servodevelop/touch-leader-arm/hardware/README.md

# Touch R1 Leader Arm 硬件

[← 首页](../README.md)　|　<sub>**简体中文**</sub>

所提供 V3.1 模型的 CAD 资源及按装配体提取的物料清单。

**目录：**

- [⚙️ 产品规格](#specifications)
- [📂 资源目录](#resources)
- [📐 装配模型](#assembly-model)
- [📋 物料清单](#bill-of-materials)
- [🔎 待确认事项](#confirmation)
- [🛠️ 装配与校准](#assembly-and-calibration)
- [✅ 验证状态](#validation-status)

## 产品规格

| 规格 | Touch R1 Leader Arm |
| --- | --- |
| 硬件版本 | V3.1，依据所提供装配体的文件名标注 |
| 产品类型 | 遥操作主臂 |
| 自由度 | 待确认 |
| 臂展与重量 | 待确认 |
| 电源与通信 | 待确认 |
| 执行器与编码器 | 待确认 |
| 关节运动范围 | 待确认 |

## 资源目录

| 目录／文件 | 内容 | 状态 |
| --- | --- | --- |
| [step/assembly/](step/assembly/) | 原始 V3.1 装配体 STEP | 源文件字节保持不变；已检查 CAD 导入 |
| [step/parts/](step/parts/) | 16 份独立零件或子装配 STEP | 已通过导出与重新导入检查 |
| [bom.json](bom.json) | BOM 数量、源编号、实例位置及几何检查结果 | 根据源装配树提取 |
| [printing/stl/](printing/stl/) | 可打印的零件网格 | 待补充 |
| [printing/3mf/](printing/3mf/) | 独立零件与整套打印项目 | 待补充 |
| [drawings/](drawings/) | 带尺寸工程图纸，PDF／DWG | 待补充 |
| [robot-description/](robot-description/) | URDF、网格和可视化说明 | 仅有框架；模型待补充 |

## 装配模型

[下载 V3.1 装配体 STEP](step/assembly/touch-leader-arm-v3.1-1013.stp)。

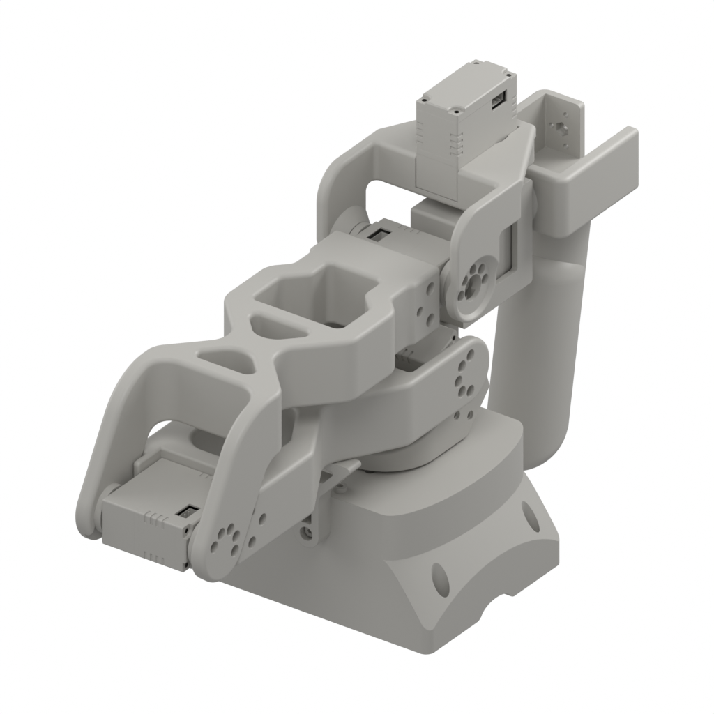
[picture p1: hardware/touch-leader-arm/images/touch-r1-assembly.png]
Touch R1 V3.1 CAD 装配体


所提供的文件 `遥操臂V3.1_1013.stp` 以 `touch-leader-arm-v3.1-1013.stp` 保存，内容未作修改。STEP 文件头记录的导出软件为 Creo Parametric，导出时间为 `2026-10-13T11:21:50`。版本标注来自源文件名。

独立 STEP 保留各组件自身的 CAD 坐标系；舵机导出件保留内部几何，作为完整子装配提供。这些文件为参考 CAD 导出件，尚未指定制造或打印工艺。

## 物料清单

下表列出一套所提供装配体中的 **16 种源项目、21 个顶层实例**。数量来自 STEP 装配引用，按源 PRODUCT 标识合并重复件。两类舵机子装配各出现 3 次，其内部零件已包含在子装配中，不再重复列为采购项。展开全部子装配后为 **99 个叶级实例／实体**，不代表需要采购 99 件物料。

结构件的资源标识与 STEP、图片文件名主体一致（不含扩展名）；螺钉采用 102 的“品名＋直径 × 长度”规格写法，链接仍指向对应 STEP。包括紧固件在内的全部简图均由源 STEP 几何渲染为 **1024 × 1024 白底图片**，点击可放大。统一灰色显示材质不代表实物材质、颜色或表面处理；各图独立缩放。

表内 CAD 包围尺寸为**零件本地坐标轴 X × Y × Z 的包围盒尺寸**，四舍五入到 0.01 mm，仅描述模型外包范围，不是工程尺寸、公差、螺纹尺寸或采购规格。螺钉条目另按圆柱面测量杆径、头径、头高及头下长度，**M3 × 4 为 CAD 推定规格**，不表示螺纹已确认。这份 CAD 提取 BOM 需要工程确认后才能用于采购；不会推测补入源模型中缺失的组件。

| 序号 | 品名 | 型号／规格 | 图片 | 描述 | 数量 |
| :---: | --- | --- | :---: | --- | :---: |
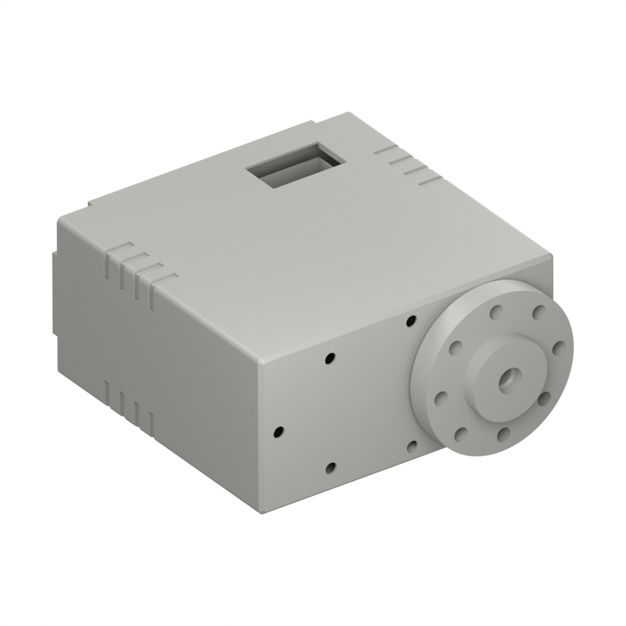
[picture p2: hardware/images/touch-r1-servo-rp8-u45h-m-c028.png]
touch-r1-servo-rp8-u45h-m-c028
| 1 | 舵机子装配 | [touch-r1-servo-rp8-u45h-m-c028](step/parts/touch-r1-servo-rp8-u45h-m-c028.step) |  | 源名称：`RP8-U45H-M-C028_STEP_ASM`<br>CAD 包围尺寸：40.10 × 45.80 × 20.21 mm。<br>源标签为 RP8-U45H-M-C028；含舵盘及内部 CAD 零件。交付配置待确认。 | 3 |
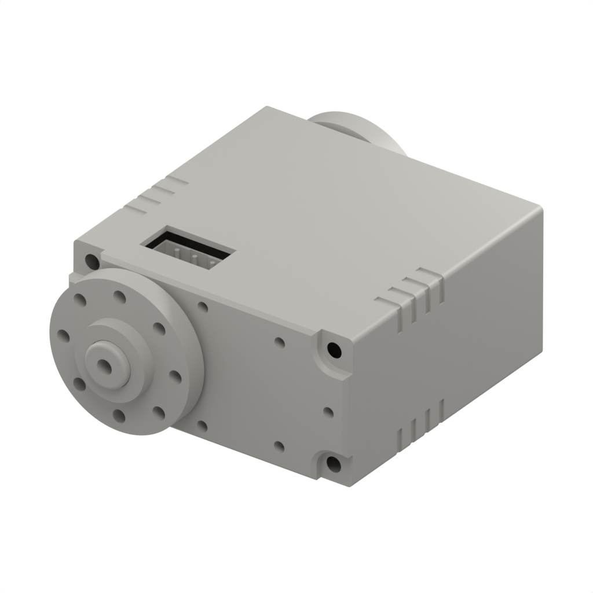
[picture p3: hardware/images/touch-r1-servo-25-50kg-0001.png]
touch-r1-servo-25-50kg-0001
| 2 | 舵机子装配（型号待确认） | [touch-r1-servo-25-50kg-0001](step/parts/touch-r1-servo-25-50kg-0001.step) |  | 源名称：`_25-50KG-0001_ASM_ASM`<br>CAD 包围尺寸：40.10 × 52.60 × 20.21 mm。<br>源标签为通用装配编号，不能据此确定采购型号；含舵盘及内部零件。 | 3 |
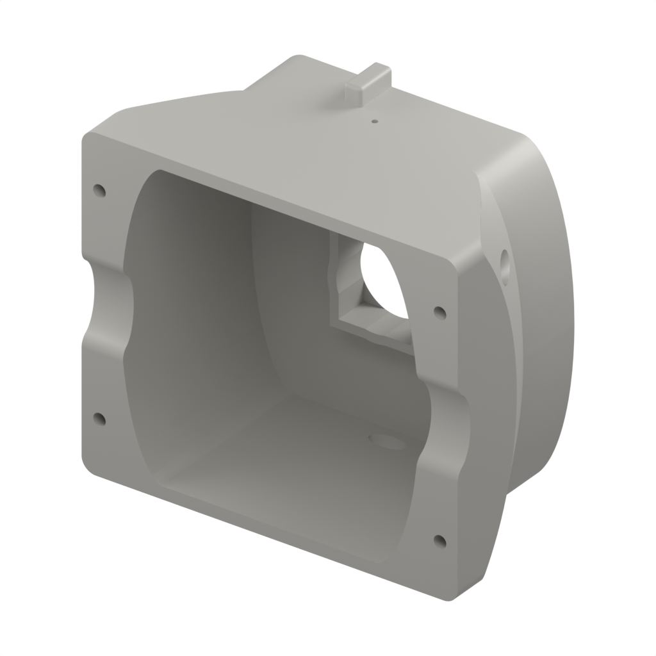
[picture p4: hardware/images/touch-r1-joint-1.png]
touch-r1-joint-1
| 3 | 关节 1 结构件 | [touch-r1-joint-1](step/parts/touch-r1-joint-1.step) |  | 源名称：`关节1_NEW`<br>CAD 包围尺寸：120.03 × 56.00 × 120.02 mm。<br>材质与制造工艺待确认。 | 1 |
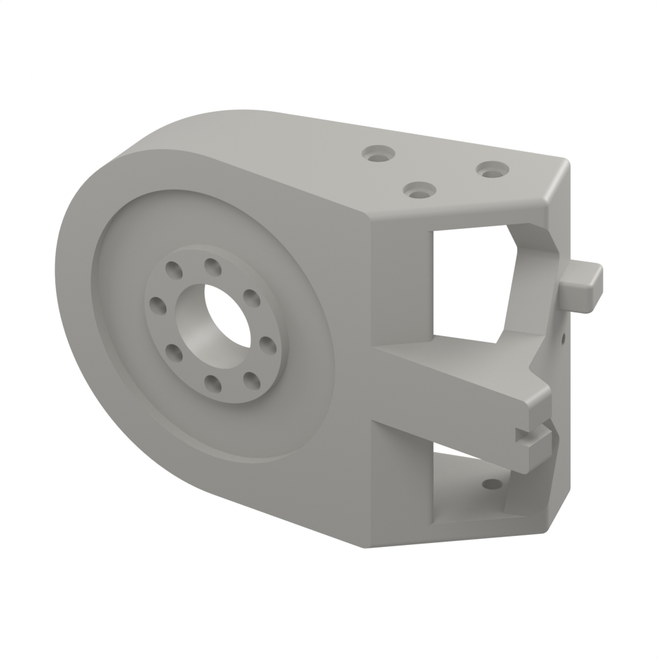
[picture p5: hardware/images/touch-r1-joint-2.png]
touch-r1-joint-2
| 4 | 关节 2 结构件 | [touch-r1-joint-2](step/parts/touch-r1-joint-2.step) |  | 源名称：`关节2_新`<br>CAD 包围尺寸：69.27 × 27.42 × 46.15 mm。<br>材质与制造工艺待确认。 | 1 |
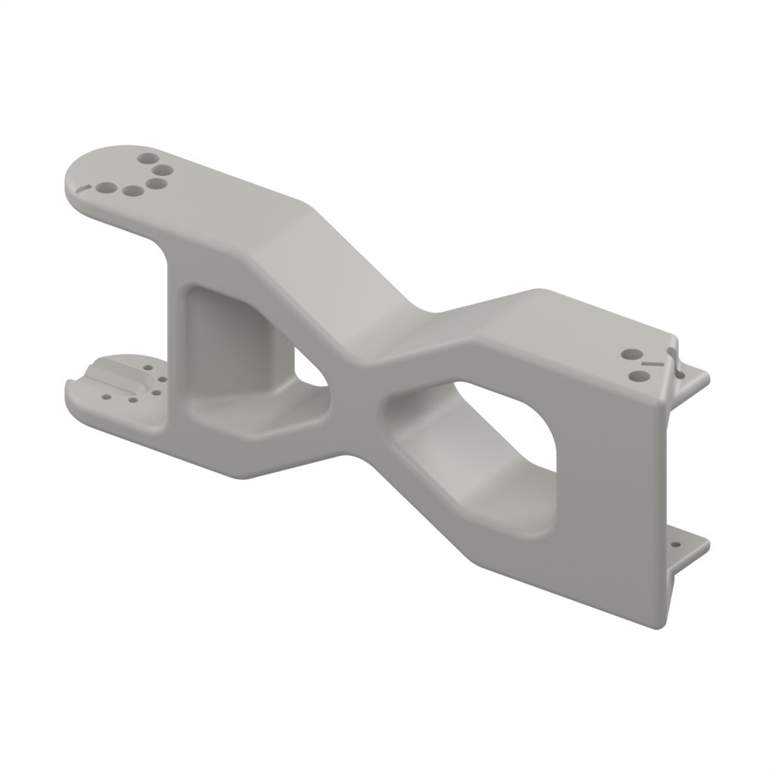
[picture p6: hardware/images/touch-r1-joint-3.png]
touch-r1-joint-3
| 5 | 关节 3 结构件 | [touch-r1-joint-3](step/parts/touch-r1-joint-3.step) |  | 源名称：`关节3`<br>CAD 包围尺寸：170.96 × 30.31 × 61.65 mm。<br>材质与制造工艺待确认。 | 1 |
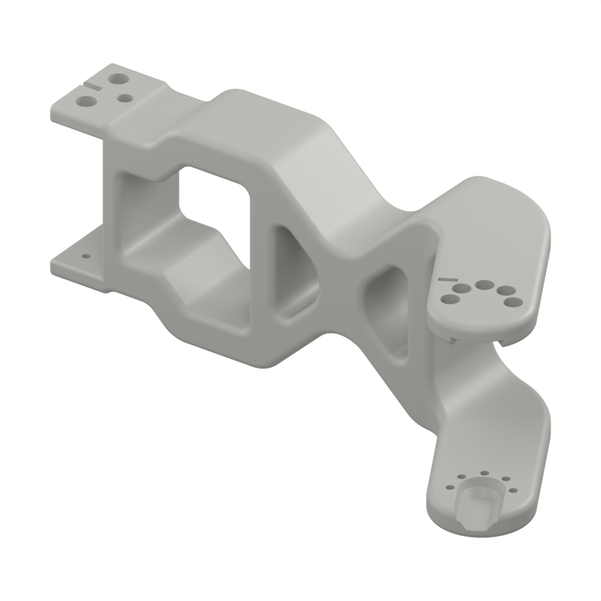
[picture p7: hardware/touch-leader-arm/images/touch-r1-joint-4.png]
touch-r1-joint-4
| 6 | 关节 4 结构件 | [touch-r1-joint-4](step/parts/touch-r1-joint-4.step) |  | 源名称：`关节4`<br>CAD 包围尺寸：167.35 × 70.38 × 63.65 mm。<br>材质与制造工艺待确认。 | 1 |
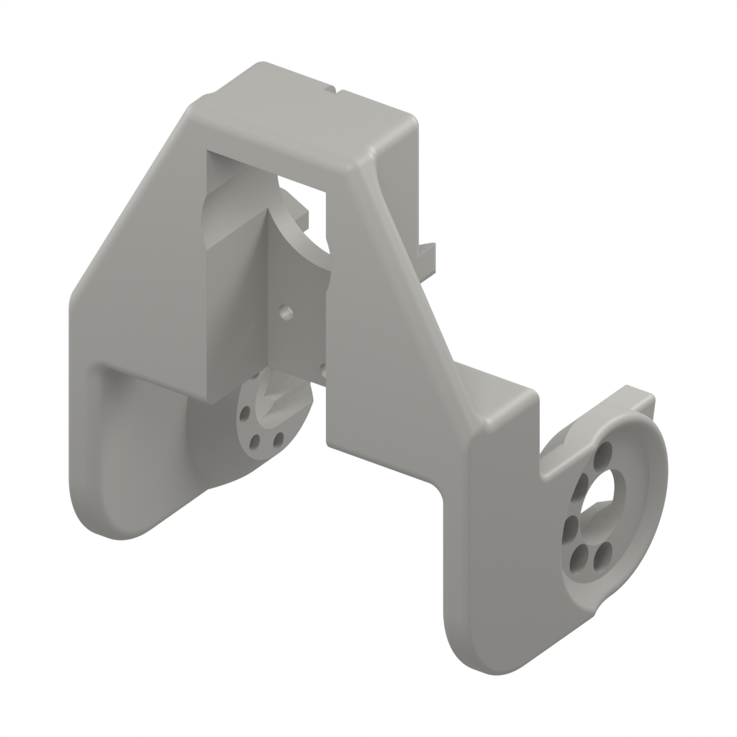
[picture p8: hardware/touch-leader-arm/images/touch-r1-joint-5.png]
touch-r1-joint-5
| 7 | 关节 5 结构件 | [touch-r1-joint-5](step/parts/touch-r1-joint-5.step) |  | 源名称：`关节5_NEW`<br>CAD 包围尺寸：69.52 × 53.85 × 83.00 mm。<br>材质与制造工艺待确认。 | 1 |
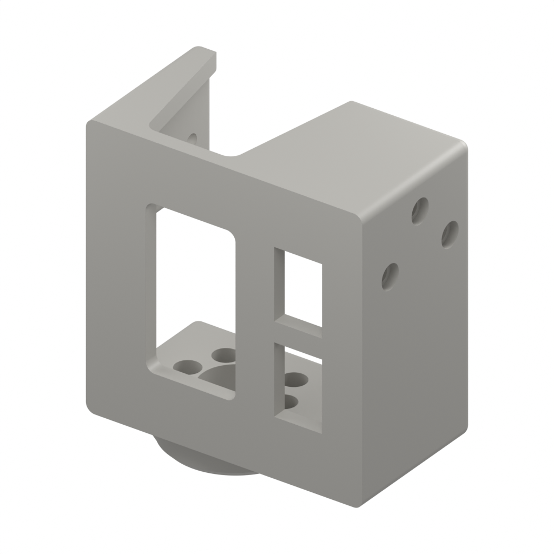
[picture p9: hardware/images/touch-r1-joint-6.png]
touch-r1-joint-6
| 8 | 关节 6 结构件 | [touch-r1-joint-6](step/parts/touch-r1-joint-6.step) |  | 源名称：`关节6_NEW`<br>CAD 包围尺寸：46.20 × 25.75 × 51.70 mm。<br>材质与制造工艺待确认。 | 1 |
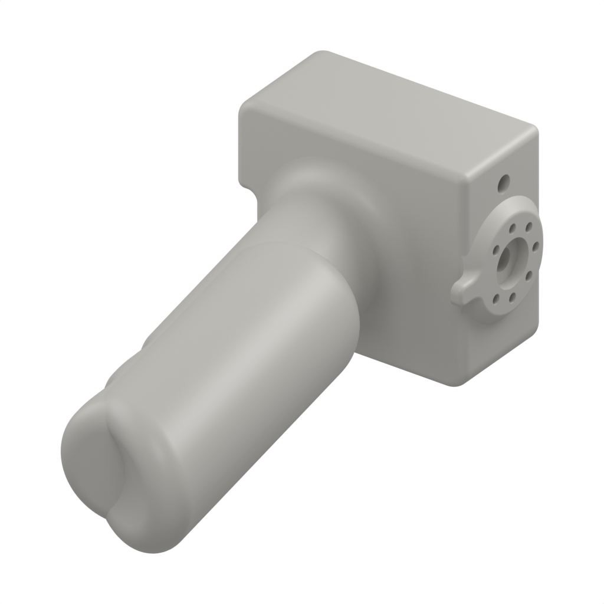
[picture p10: hardware/touch-leader-arm/images/touch-r1-joint-7.png]
touch-r1-joint-7
| 9 | 关节 7 手柄结构件 | [touch-r1-joint-7](step/parts/touch-r1-joint-7.step) |  | 源名称：`关节7`<br>CAD 包围尺寸：65.25 × 135.66 × 51.22 mm。<br>CAD 中包含手柄外形；材质与制造工艺待确认。 | 1 |
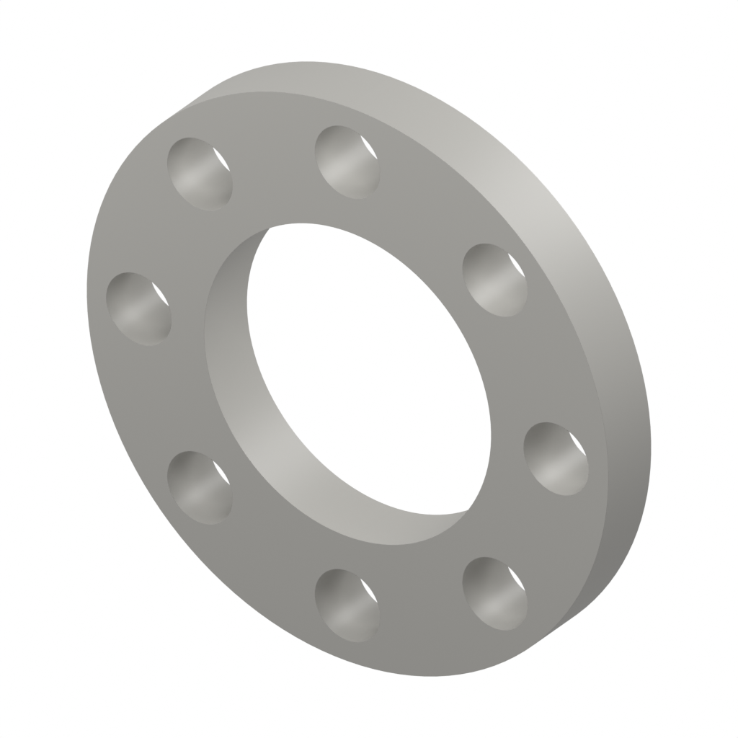
[picture p11: hardware/touch-leader-arm/images/touch-r1-spacer.png]
touch-r1-spacer
| 10 | 垫片 | [touch-r1-spacer](step/parts/touch-r1-spacer.step) |  | 源名称：`垫片`<br>CAD 包围尺寸：20.00 × 2.30 × 20.00 mm。<br>带孔垫片；材质与配合公差待确认。 | 1 |
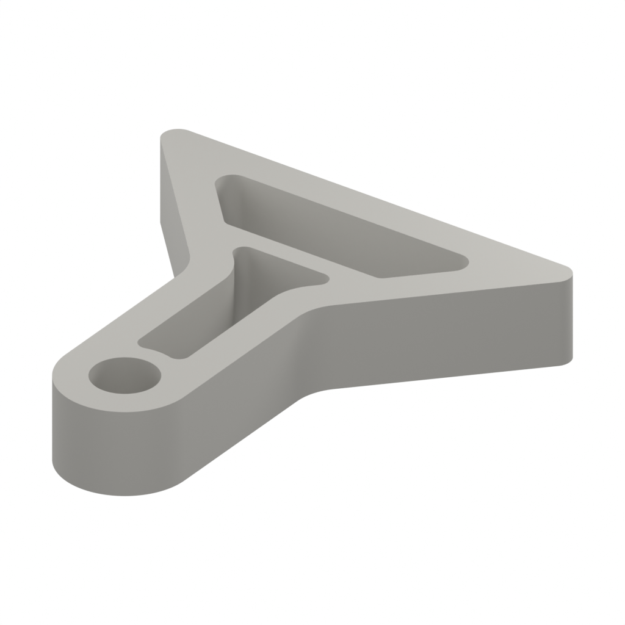
[picture p12: hardware/touch-leader-arm/images/touch-r1-part-a000.png]
touch-r1-part-a000
| 11 | 支架 A000（用途待确认） | [touch-r1-part-a000](step/parts/touch-r1-part-a000.step) |  | 源名称：`A000`<br>CAD 包围尺寸：41.12 × 41.76 × 8.00 mm。<br>保留源编号；用途、材质及工艺待确认。 | 1 |
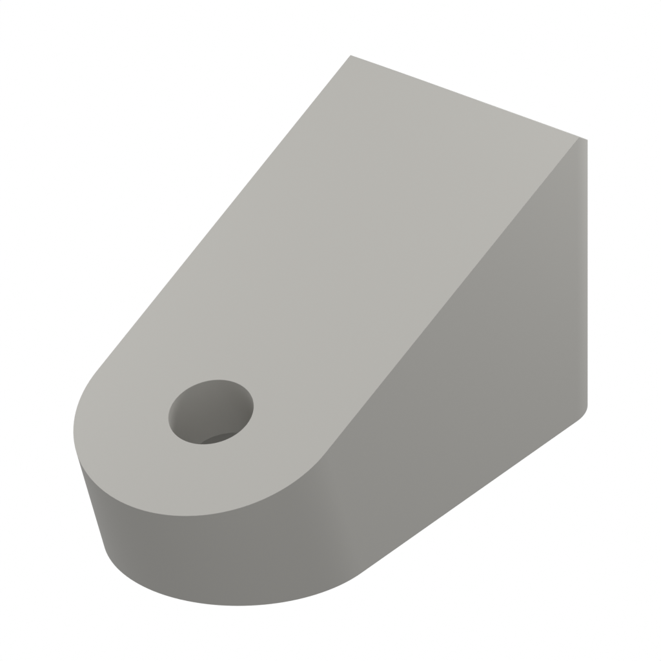
[picture p13: hardware/touch-leader-arm/images/touch-r1-part-b000.png]
touch-r1-part-b000
| 12 | 支架 B000（用途待确认） | [touch-r1-part-b000](step/parts/touch-r1-part-b000.step) |  | 源名称：`B000`<br>CAD 包围尺寸：10.00 × 22.11 × 13.51 mm。<br>保留源编号；用途、材质及工艺待确认。 | 1 |
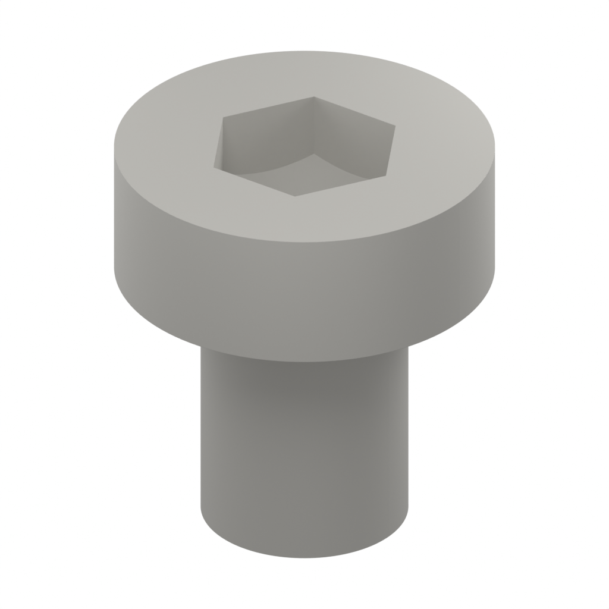
[picture p14: hardware/touch-leader-arm/images/touch-r1-fastener-prt0001.png]
| 13 | 内六角圆柱头螺钉 | [M3 × 4（CAD 推定，螺纹待确认）](step/parts/touch-r1-fastener-prt0001.step) |  | 源名称：`PRT0001`<br>CAD：杆径 Ø3 mm，头下长 4 mm；头径 Ø5.5 mm，头高 2 mm。<br>螺纹／螺距、标准、材质、强度等级及表面处理待确认。 | 1 |
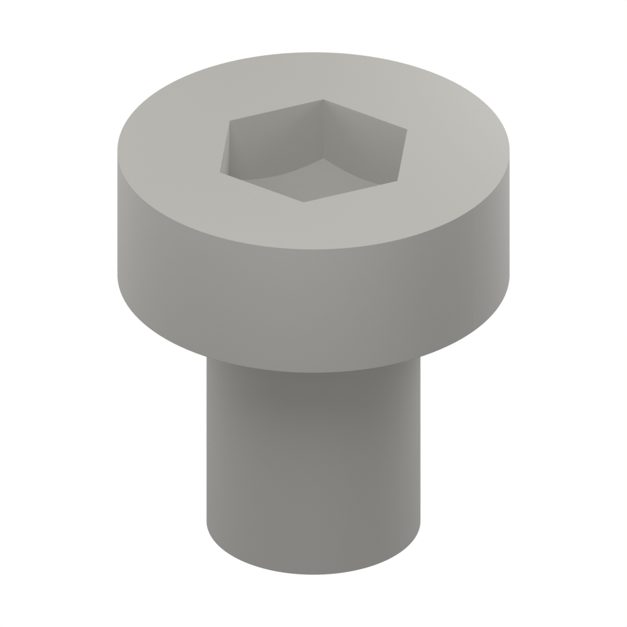
[picture p15: hardware/images/touch-r1-fastener-prt0002.png]
| 14 | 内六角圆柱头螺钉 | [M3 × 4（CAD 推定，螺纹待确认）](step/parts/touch-r1-fastener-prt0002.step) |  | 源名称：`PRT0002`<br>CAD：杆径 Ø3 mm，头下长 4 mm；头径 Ø5.5 mm，头高 2 mm。<br>螺纹／螺距、标准、材质、强度等级及表面处理待确认。 | 1 |
| 15 | 内六角圆柱头螺钉 | [M3 × 4（CAD 推定，螺纹待确认）](step/parts/touch-r1-fastener-gb-t70-1-m3x400.step) | <a href="images/touch-r1-fastener-gb-t70-1-m3x400.png">内六角圆柱头螺钉 CAD 简图</a> | 源名称：`GB_T70_1-M3X400`<br>CAD：杆径 Ø3 mm，头下长 4 mm；头径 Ø5.5 mm，头高 2 mm。<br>螺纹／螺距、标准、材质、强度等级及表面处理待确认。 | 1 |
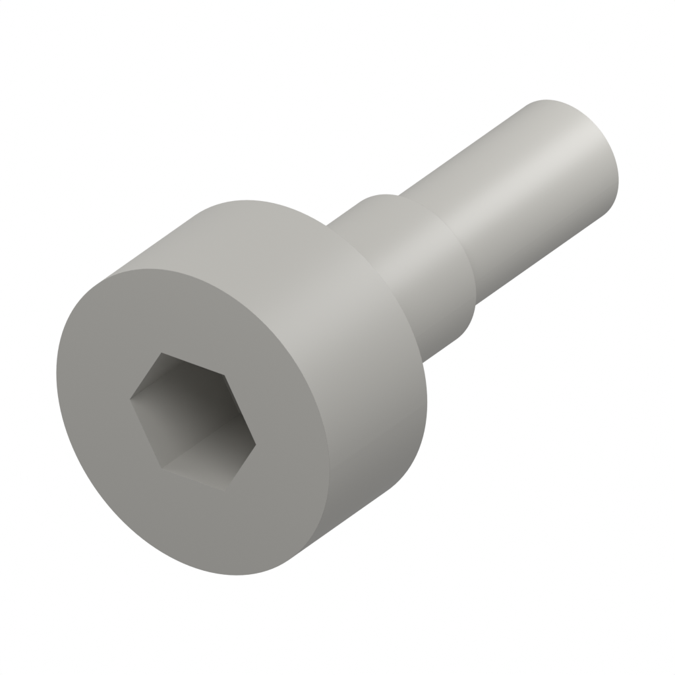
[picture p16: hardware/touch-leader-arm/images/touch-r1-fastener-m3x3x60001.png]
内六角台阶螺钉 CAD 简图
| 16 | 内六角台阶螺钉 | [台阶段 Ø2.5 × 3 mm；末段 Ø2 × 4 mm（螺纹待确认）](step/parts/touch-r1-fastener-m3x3x60001.step) |  | 源名称：`M3X3X60001`<br>CAD：头径 Ø5 mm，头高 2.5 mm；头下总长 7 mm。<br>源名称含 M3，与实测分段直径不一致；螺纹／螺距、标准、材质、强度等级及表面处理待确认。 | 2 |

规格写法参考 [Star Arm 102-HD 物料清单](https://github.com/servodevelop/Star-Arm-102/blob/main/hardware/102-hd/README.zh.md#bill-of-materials)。102 的 M3 × 10、M3 × 22、M2 × 8 等尺寸以及黑色表面、12.9 级等采购属性不自动适用于 R1；本表保留 R1 的实测尺寸和源实例数量。

## 待确认事项

- 确认 `_25-50KG-0001_ASM_ASM` 的准确采购型号与交付内容。不能仅凭名称确定扭矩、电压、编码器或输出轴规格；标注为 RP8-U45H-M-C028 的子装配也需核对实际配置。
- `PRT0001`、`PRT0002`、`GB_T70_1-M3X400` 的杆径均为 3 mm、头下长均为 4 mm，暂按 **M3 × 4（CAD 推定）** 表达；CAD 头高均为 2 mm，不能根据第三项源名称直接确认 GB/T 70.1 标准符合性。三个源 PRODUCT 各 1 件，在采购规格及互换性确认前保留三行。
- 台阶件 `M3X3X60001` 共 2 件，测得台阶段 Ø2.5 × 3 mm、末段 Ø2 × 4 mm；不据名称认定为 M3，也不把末段直径直接当作 M2 螺纹。需核对图纸或实物。
- 确认 A000、B000 的用途，以及全部结构件的材质、制造工艺和公差。不预设 PLA、打印参数或加工方式。
- 确认实物所需的完整紧固件、线缆、控制板、电源及配件。源装配树中只有 5 个顶层紧固件实例，不代表用 5 个紧固件就能完成装配。源名称中的关节 1–7 也不能据此认定机械臂的驱动自由度。

## 装配与校准

装配顺序、经确认的紧固件规格、接线、关节限位及零位校准说明待补充。

现有 [Python 遥操作指南](../python-sdk/README.md) 面向 Star Arm 102 → Lumos；与此 V3.1 装配体的兼容性尚未验证。

## 验证状态

| 项目 | 状态 |
| --- | --- |
| 源装配体 | SHA-256 与附件一致；1 个根装配、21 个顶层实例 |
| CAD 导入 | 99 个实体；通过 FreeCAD 形体有效性检查 |
| 16 份 STEP 导出件 | 已成功重新导入；实体数不变，最大相对体积差低于 0.0011%，包围尺寸差低于 0.001 mm |
| BOM 数量 | 已交叉核对 STEP 引用与导入对象；源映射保留于 bom.json |
| 螺钉尺寸 | 已核查 4 种源模型的圆柱面与头下长度；螺纹及采购属性待确认 |
| 零件简图 | 根据 CAD 网格渲染；使用中性显示材质；各图独立缩放 |
| 干涉、配合与实物装配 | 尚未验证 |
| 采购 BOM 完整性与硬件规格 | 待工程确认 |
| 可打印性、URDF 与仿真 | 尚未验证；未提供打印文件和 URDF |
| V3.1 的 Python 遥操作 | 尚未验证 |

几何检查用于验证 CAD 导入导出一致性，不代表通过制造验收。重新生成导出件和简图的方法见 [生成说明](../scripts/README.md)。
