servodevelop/touch-leader-arm/hardware/README.zh.md

# Touch R1 Leader Arm 硬件资源

文档已统一使用中文，正文请查看 [当前文档](README.md)。
