servodevelop/touch-leader-arm/docs/README.zh.md

# Touch R1 Leader Arm 文档中心

文档已统一使用中文，正文请查看 [当前文档](README.md)。
