servodevelop/touch-leader-arm/python-sdk/README.zh.md

# Star Arm 102 → Lumos Python 遥操作

文档已统一使用中文，正文请查看 [当前文档](README.md)。

[查看：硬件与环境](README.md#requirements)

[查看：安装](README.md#installation)

[查看：CAN 接口](README.md#can-interface)

[查看：首次校准](README.md#calibration)

[查看：先预览，再执行](README.md#teleoperation)

[查看：HD 按钮悬停](README.md#hd-button)

[查看：调整关节映射与速度](README.md#configuration)

[查看：目录内容](README.md#directory-structure)
