servodevelop/touch-leader-arm/hardware/robot-description/README.md

# Touch R1 Leader Arm 机器人描述

[← Touch R1 Leader Arm 硬件](../README.md)　|　<sub>**简体中文**</sub>

V3.1 机器人描述待补充。资料就绪后，此目录将提供 URDF 软件包、配套网格资源及可视化说明。

## 模型框架

| 项目 | 状态 |
| --- | --- |
| 连杆与关节定义 | 待补充 |
| 可视化与碰撞网格 | 待补充 |
| 关节限位、质量与惯量 | 待确认 |
| ROS 版本与软件包结构 | 待确认 |
| 可视化与仿真命令 | 待验证 |

添加机器人描述软件包时，将运行所需网格保留在包内。已有 [装配体 STEP](../step/assembly/touch-leader-arm-v3.1-1013.stp) 可供 CAD 参考；目前尚未提供 URDF 或可运行的 ROS 软件包。
