servodevelop/touch-leader-arm/hardware/robot-description/README.zh.md

# Touch R1 Leader Arm 机器人描述

文档已统一使用中文，正文请查看 [当前文档](README.md)。
