servodevelop/touch-leader-arm/hardware/touch-leader-arm/README.zh.md

# Touch R1 Leader Arm 硬件

文档已统一使用中文，正文请查看 [当前文档](README.md)。

[查看：资源目录](README.md#resources)

[查看：装配模型](README.md#assembly-model)

[查看：物料清单](README.md#bill-of-materials)

[查看：待确认事项](README.md#confirmation)

[查看：装配与校准](README.md#assembly-and-calibration)

[查看：验证状态](README.md#validation-status)
