servodevelop/touch-leader-arm/hardware/touch-leader-arm/robot-description/README.md

# Touch Leader Arm Robot Description

[← Touch Leader Arm Hardware](../README.md)　|　<sub>**English** / [简体中文](README.zh.md)</sub>

The V3.1 robot description is pending. This directory will contain the URDF package, its mesh assets, and visualization instructions once available.

## Model framework

| Item | Status |
| --- | --- |
| Link and joint definitions | Pending |
| Visual and collision meshes | Pending |
| Joint limits, masses, and inertia | Pending confirmation |
| ROS version and package layout | Pending confirmation |
| Visualization and simulation commands | Pending validation |

Keep runtime mesh assets inside the robot description package when adding it. The [assembly STEP](../step/assembly/touch-leader-arm-v3.1-1013.stp) is available as a CAD reference; no URDF or runnable ROS package is supplied yet.
