servodevelop/touch-leader-arm/scripts/README.zh.md

# 仓库维护脚本

文档已统一使用中文，正文请查看 [当前文档](README.md)。
