servodevelop/touch-leader-arm/hardware/step/parts/touch-r1-servo-rp8-u45h-m-c028.step

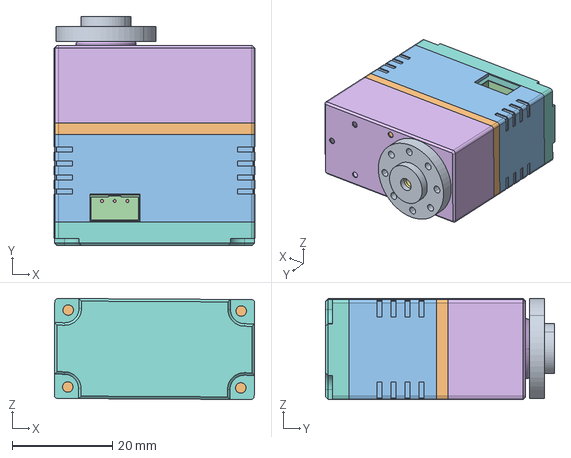
[picture p17: CAD file, 2026-10-15]
hardware/step/parts/touch-r1-servo-rp8-u45h-m-c028.step
40.1 x 45.8 x 20.2 mm
