servodevelop/touch-leader-arm/hardware/touch-leader-arm/step/parts/touch-r1-joint-7.step

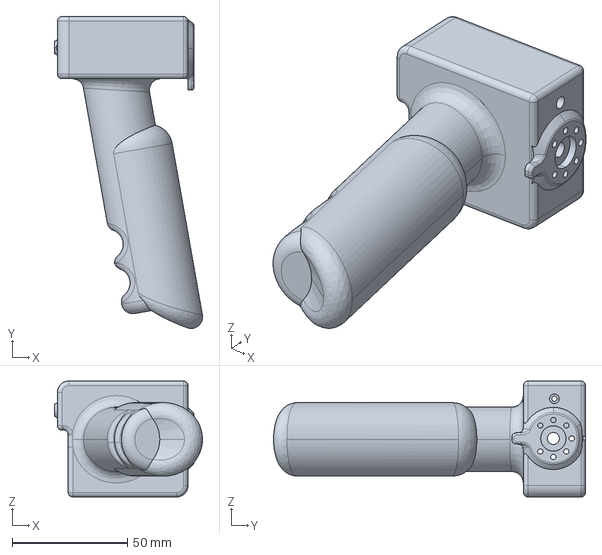
[picture p19: CAD file, 2026-10-15]
hardware/touch-leader-arm/step/parts/touch-r1-joint-7.step
64.4 x 135.6 x 50.4 mm
