servodevelop/touch-leader-arm/hardware/step/parts/touch-r1-fastener-prt0002.step

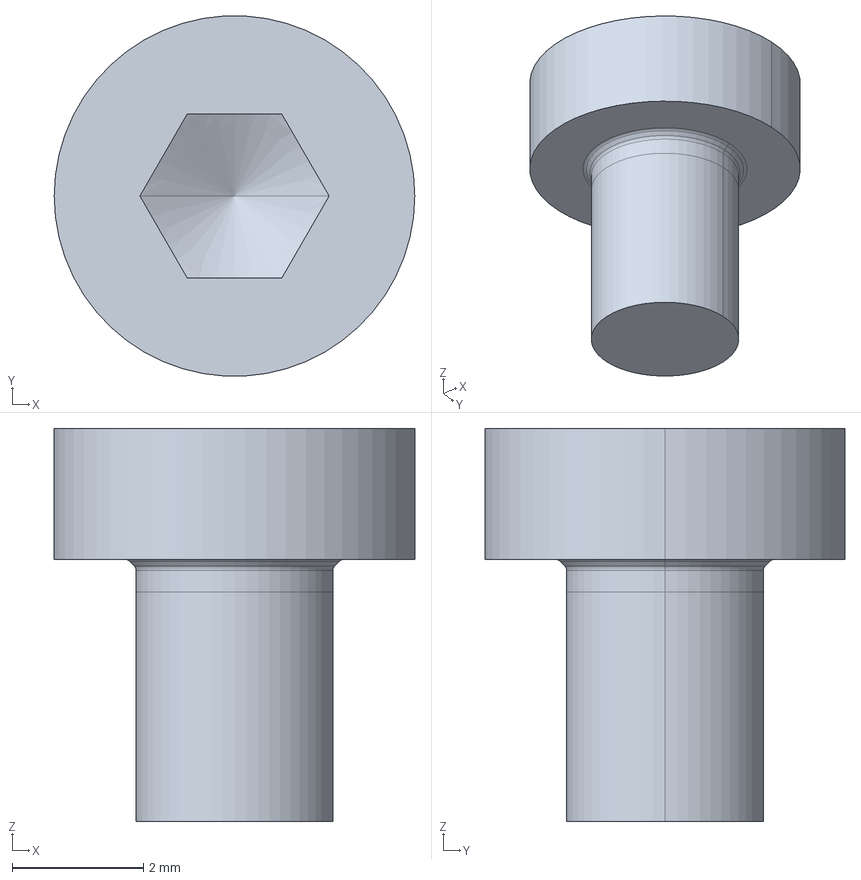
[picture p20: CAD file, 2026-10-15]
hardware/step/parts/touch-r1-fastener-prt0002.step
5.50 x 5.49 x 6.00 mm
