servodevelop/touch-leader-arm/hardware/touch-leader-arm/step/parts/touch-r1-joint-3.step

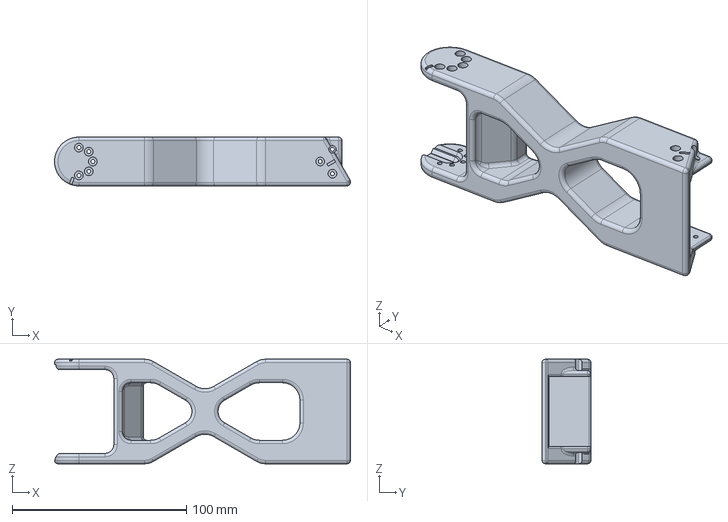
[picture p21: CAD file, 2026-10-15]
hardware/touch-leader-arm/step/parts/touch-r1-joint-3.step
169.8 x 28.0 x 60.0 mm
