servodevelop/touch-leader-arm/hardware/touch-leader-arm/step/parts/touch-r1-joint-1.step

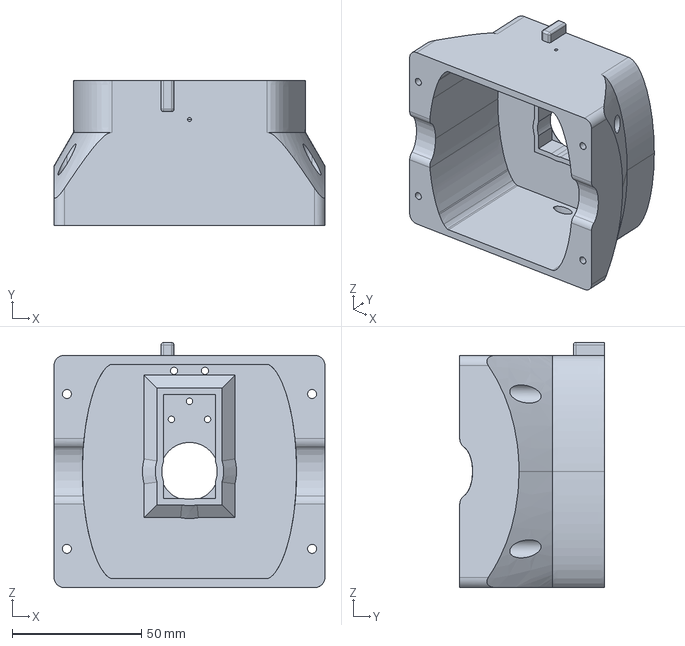
[picture p22: CAD file, 2026-10-15]
hardware/touch-leader-arm/step/parts/touch-r1-joint-1.step
105.0 x 56.0 x 95.0 mm
