servodevelop/touch-leader-arm/hardware/touch-leader-arm/step/parts/touch-r1-part-b000.step

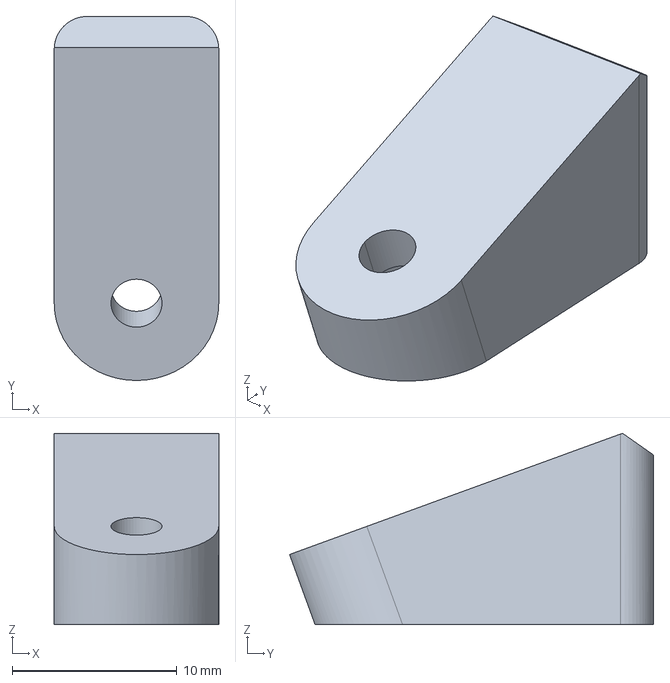
[picture p24: CAD file, 2026-10-15]
hardware/touch-leader-arm/step/parts/touch-r1-part-b000.step
10.0 x 22.1 x 11.6 mm
