servodevelop/touch-leader-arm/hardware/step/parts/touch-r1-joint-6.step

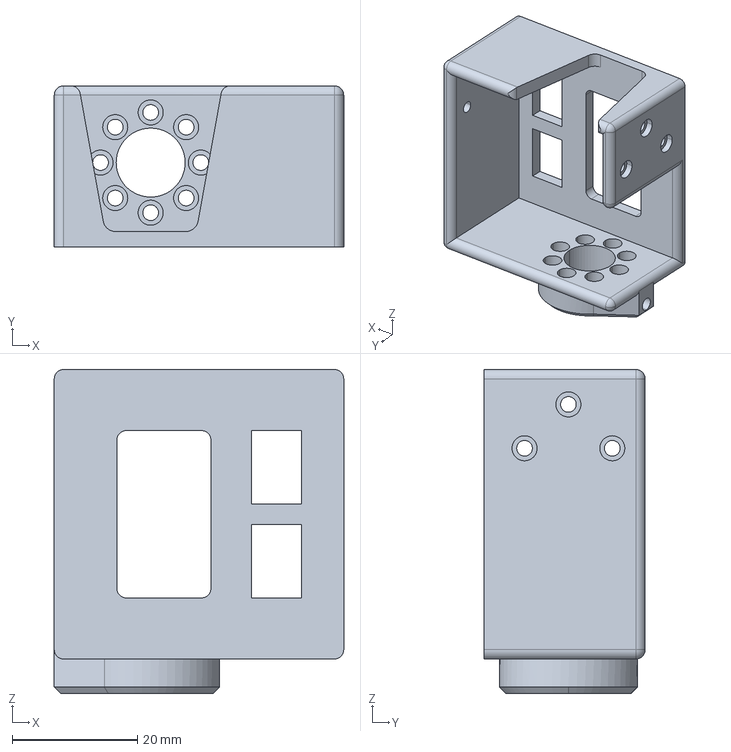
[picture p25: CAD file, 2026-10-15]
hardware/step/parts/touch-r1-joint-6.step
46.2 x 25.8 x 51.7 mm
