servodevelop/touch-leader-arm/hardware/touch-leader-arm/step/parts/touch-r1-servo-25-50kg-0001.step

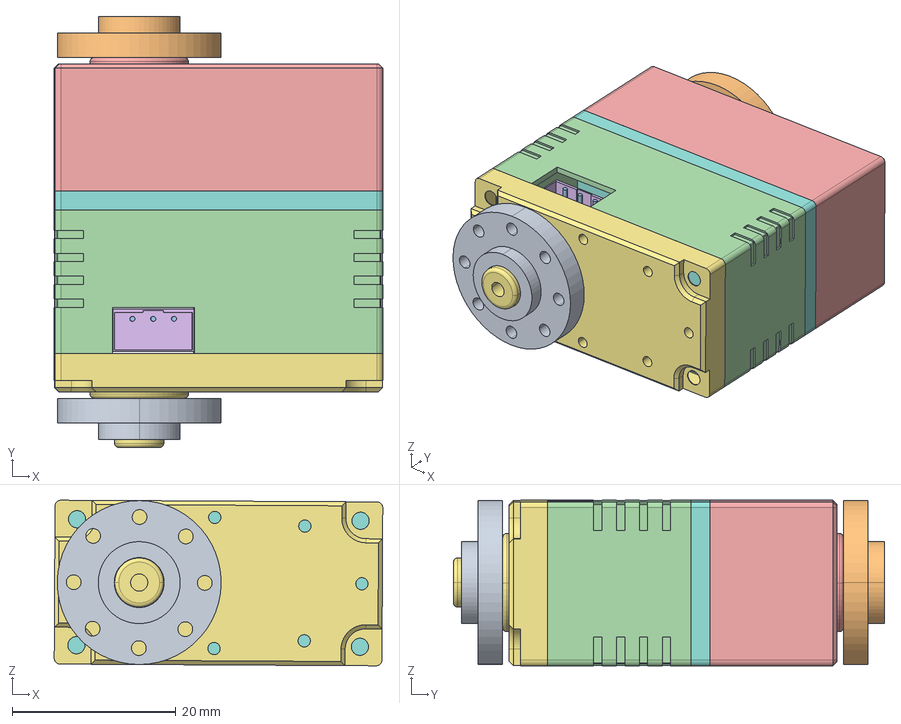
[picture p26: CAD file, 2026-10-15]
hardware/touch-leader-arm/step/parts/touch-r1-servo-25-50kg-0001.step
40.1 x 52.6 x 20.2 mm
