servodevelop/touch-leader-arm/hardware/step/parts/touch-r1-joint-2.step

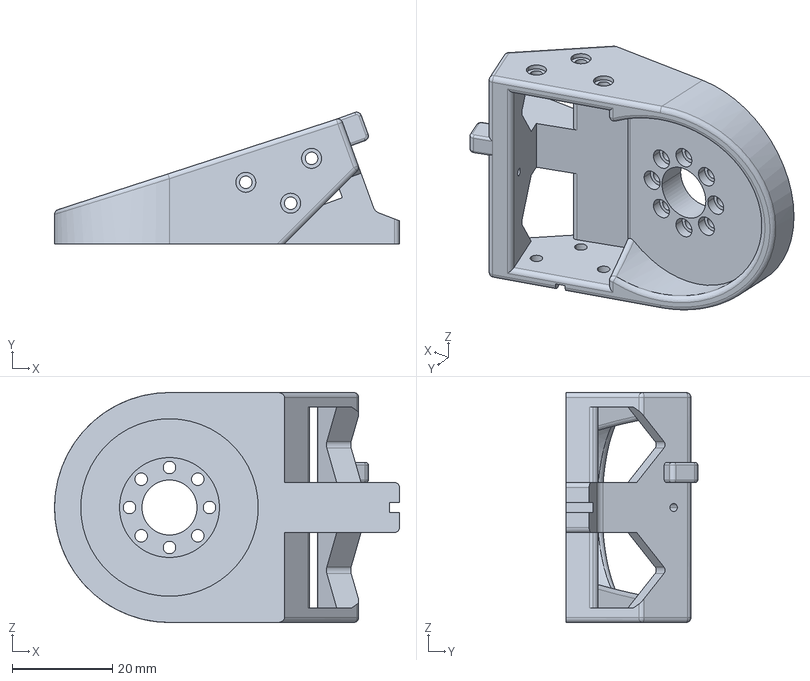
[picture p27: CAD file, 2026-10-15]
hardware/step/parts/touch-r1-joint-2.step
69.0 x 26.3 x 46.0 mm
