servodevelop/touch-leader-arm/hardware/touch-leader-arm/step/parts/touch-r1-spacer.step

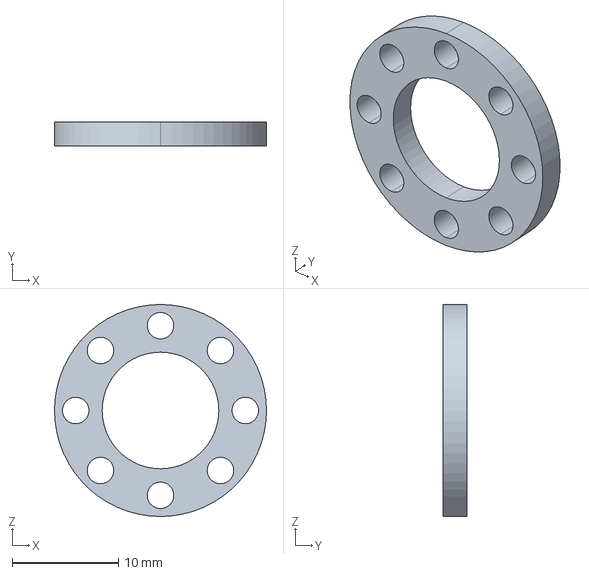
[picture p28: CAD file, 2026-10-15]
hardware/touch-leader-arm/step/parts/touch-r1-spacer.step
20.0 x 2.30 x 20.0 mm
