servodevelop/touch-leader-arm/hardware/touch-leader-arm/step/parts/touch-r1-fastener-m3x3x60001.step

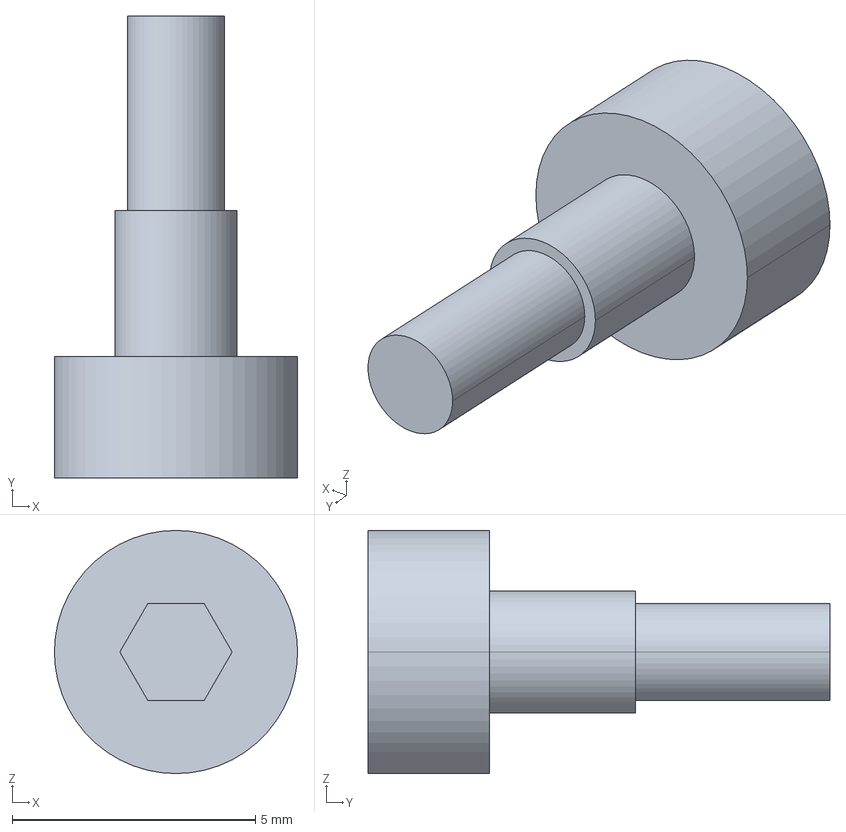
[picture p29: CAD file, 2026-10-15]
hardware/touch-leader-arm/step/parts/touch-r1-fastener-m3x3x60001.step
5.00 x 9.50 x 5.00 mm
