servodevelop/touch-leader-arm/hardware/step/parts/touch-r1-part-a000.step

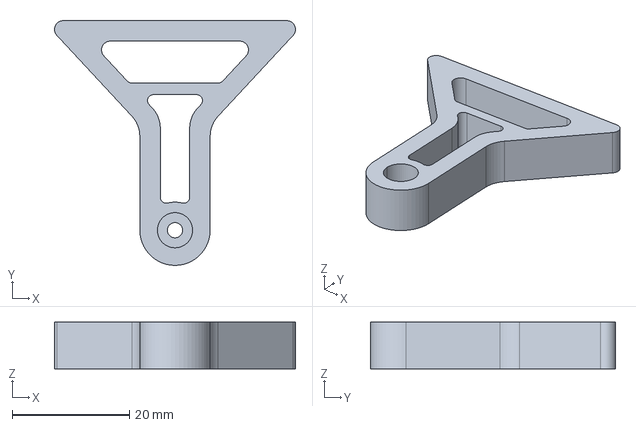
[picture p30: CAD file, 2026-10-15]
hardware/step/parts/touch-r1-part-a000.step
41.1 x 41.8 x 8.00 mm
