servodevelop/touch-leader-arm/hardware/touch-leader-arm/step/parts/touch-r1-joint-4.step

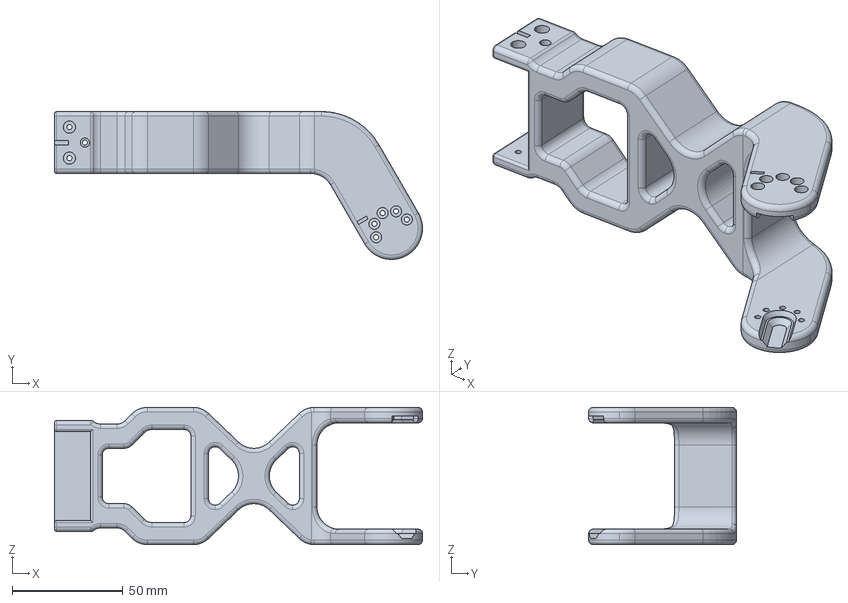
[picture p31: CAD file, 2026-10-15]
hardware/touch-leader-arm/step/parts/touch-r1-joint-4.step
166.2 x 66.7 x 62.0 mm
