servodevelop/touch-leader-arm/(list of files, cad)

Other CAD files:
hardware/step/parts/touch-r1-fastener-prt0001.step
hardware/step/parts/touch-r1-fastener-gb-t70-1-m3x400.step
