servodevelop/touch-leader-arm/docs/StarArm102_Lumos_Python_Teleoperation_Guide.docx

# Star Arm 102 控制 Lumos

Python 遥操作安装与使用指南

用途 用 Star Arm 102 主臂实时控制 Lumos 单臂。程序通过 Star Arm UART 和 Lumos CAN 通信，不使用 LeRobot。首次使用先校准，再预览，最后执行。

# 1 设备与控制关系

Star Arm 102 主臂提供操作输入，Lumos 单臂作为被控机械臂。脚本读取 Star Arm 102 的六个关节和可选夹爪状态，再向 Lumos SDK 发送六关节目标和夹爪开度。

设备 | 连接 | 默认值
Star Arm 102 主臂 | USB 转串口 | /dev/ttyUSB0
Lumos 单臂 | CAN | can0，1,000,000 bit/s
Lumos 夹爪 | 随 Lumos SDK 控制 | 可选；命令需加 --gripper

# 2 运行环境与程序文件

在连接两台设备的 Ubuntu 电脑上运行。Lumos SDK 支持 Ubuntu 20.04、22.04、24.04；建议使用 Python 3.10。StarArm SDK、Lumos SDK 和遥操作脚本必须安装或运行在同一个 Python 环境中。

## 下载程序并一键安装依赖

git clone https://github.com/servodevelop/touch-leader-arm.git
cd touch-leader-arm/python-sdk
bash scripts/install_ubuntu.sh

请先激活 Python 3.10 环境。安装脚本会安装 C++ 构建依赖和 StarArm Python 包，并自动将 Lumos SDK 下载到python-sdk/.dependencies/startouch_sdk 目录后完成安装。整个过程需要联网和 sudo 权限；不需要手动进入 SDK 源码目录。

Lumos SDK 源码由脚本从 Lumos 官方仓库自动获取，本项目不复制或再分发该 SDK 源码。安装完成后可检查接口：

python -c "import serial, fashionstar_uart_sdk; from startouchclass import SingleArm; print('SDK OK')"

## 手动安装（排错时使用）

如果需要逐步安装，请在已激活的 Python 3.10 环境和python-sdk/ 目录执行以下命令。SDK 会下载到 .dependencies/startouch_sdk，无需手动切换到 SDK 源码目录。

sudo apt-get update
sudo apt-get install -y build-essential cmake pkg-config libeigen3-dev libyaml-cpp-dev liborocos-kdl-dev libtinyxml2-dev pybind11-dev

python -m pip install --upgrade pip setuptools wheel
python -m pip install pyserial fashionstar-uart-sdk

mkdir -p .dependencies
if [ ! -d .dependencies/startouch_sdk ]; then
git clone --depth 1 https://github.com/lumos-open/startouch_sdk.git .dependencies/startouch_sdk
fi
python -m pip install -r .dependencies/startouch_sdk/requirements.txt
python -m pip install .dependencies/startouch_sdk

## 放置程序并检查 CAN

遥操作脚本位于 python-sdk/ 目录。后续命令均在此目录执行。确认 can0 状态：

ip -details link show can0

若输出显示 UP 且速率为 1,000,000 bit/s，直接继续；若接口未启用，再执行：

sudo ip link set can0 up type can bitrate 1000000

若提示 Device or resource busy，先再次查看接口状态；若 can0 已经是 UP，不要重复设置。串口名不确定时运行 ls -l /dev/ttyUSB*，并在后续命令中替换默认端口。

# 3 固定控制参数

脚本在文件顶部的“用户可调整的遥操作参数”区域写入当前配置。需要改方向、幅度或跟随速度时，修改该处并保存脚本。运行时不会从旧校准文件覆盖这些值。

代码参数 | 当前值 | 作用
JOINT_SIGNS | (-1, 1, 1, 1, -1, -1) | 六关节方向；1 同向，-1 反向。顺序对应 Lumos 关节 1 至 6。
FOLLOW_GAIN | 1.0 | 主臂相对参考姿态的角度变化映射比例，范围 0 到 1。
MAX_STEP_DEG | 1.0° | 每个控制周期目标最多变化的角度；值越大，目标变化越快。
CONTROL_RATE_HZ | 50 Hz | 主臂采样和 Lumos 目标更新频率。

当前 MAX_STEP_DEG × CONTROL_RATE_HZ 对应的目标变化上限约为 50°/秒。Lumos 实际速度也受 SDK 和关节本身限制。出现力矩报警时不要通过加大这些值或修改保护阈值来消除报警。

# 4 首次校准

校准记录主臂的参考姿态和六关节活动范围，并记录 Lumos 当时的关节位置。若需要遥操作夹爪，校准和后续运行都要带 --gripper。校准文件保存在 ~/.config/stararm102_lumos/calibration.json。

python stararm102_lumos_teleop.py --calibrate --can can0 --leader-port /dev/ttyUSB0 --gripper

- 在开始前，将 Star Arm 102 与 Lumos 摆到相互对应且安全的参考姿态。Lumos SDK 连接时会使能电机；确认急停可用、工作区域畅通。
- 按提示开始范围记录。缓慢活动 StarArm 六个关节，覆盖实际操作所需的安全范围；全部完成后按 Enter 停止。不要强行顶到机械硬限位。
- 若启用夹爪，按提示分别记录 StarArm 夹爪完全闭合和完全打开的位置。
- 检查结束时显示的各关节最小值、最大值和范围；若范围不足或不合理，重新校准。

## 参考姿态的含义

参考姿态是遥操作映射的相对零点，不是机械臂的机械零位或电机编码器零位。主臂相对该姿态的运动量会映射到 Lumos 记录的姿态上。实际执行前，Lumos 应回到校准时的参考姿态附近。

# 5 预览与开始遥操作

## 预览

python stararm102_lumos_teleop.py --can can0 --leader-port /dev/ttyUSB0 --gripper

预览模式只读取主臂并显示输入，不向 Lumos 发送运动目标。确认主臂关节对应关系正确；需要反转夹爪时加 --invert-gripper。

## 执行

python stararm102_lumos_teleop.py --can can0 --leader-port /dev/ttyUSB0 --gripper --execute

首次执行先小幅移动一个关节，确认运动方向和范围。使用 Ctrl+C 正常停止；若机械臂卡住、碰撞或出现持续力矩报警，立即停止并使用硬件急停。

启用夹爪反向映射时，预览和执行命令都加 --invert-gripper。若没有夹爪，校准、预览和执行命令都省略 --gripper。

# 6 常见情况

提示或现象 | 处理方式
No module named startouchclass | 激活安装时使用的 Python 3.10 环境，在python-sdk/ 目录运行 bash scripts/install_ubuntu.sh。
没有校准文件 | 先运行带 --calibrate 的命令；校准完成后检查 ~/.config/stararm102_lumos/calibration.json。
姿态与校准参考姿态相差过大 | 将 Lumos 放回参考姿态附近，或重新校准。保护检查用于避免启动时目标突变。
主臂到边界后从臂不再跟随 | 主臂输入会限制在校准记录的最小值和最大值；重新校准并覆盖实际使用范围。
电机力矩报警 | 停止遥操作，检查碰撞、卡滞、线缆牵扯和机械姿态。不要绕过 SDK 的力矩保护。

# 7 参考资料

Star Arm 102 Python SDK：Python SDK guide (https://github.com/servodevelop/Star-Arm-102/blob/main/Python_SDK/PYTHON_SDK_GUIDE.md)

Star Arm 102 控制 Lumos ·

Star Arm 102 | Lumos | Python 操作指南
