servodevelop/touch-leader-arm/(commit log)

2026-10-10 Enable HD leader button holding by default
2026-10-14 Organize hardware resources, shared docs, and Python SDK
    Add a Star Arm 102-style hardware layout and the supplied V3.1 assembly
    STEP, preserving its bytes and marking unavailable resources as pending.
    Create synchronized English and Chinese resource pages and a shared root
    docs entry for assembly, calibration, and operation guides.
    Move the teleoperation program and installer into python-sdk without
    changing their implementation. Keep the Word guide under root docs and
    update repository URLs, working directories, and README links.
    Treat STEP exports as binary assets to preserve their original contents.
    Validation: local links in 12 Markdown files and structure of 6 bilingual
    README pairs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
2026-10-14 Revert "合并 Lumos 遥操作平滑、诊断与 SDK 配置定位修复"
    This reverts commit 21b7f1e66598d51ecc6c9b987f6f5877bd3d37b7, reversing
    changes made to f3bafe6cc160574b56531d1090a1e6c06ab63a63.
2026-10-15 Add illustrated Touch R1 CAD BOM and individual STEP exports
    Extract 16 BOM items covering 21 top-level occurrences from the supplied
    V3.1 STEP assembly. Keep complete servo subassemblies together and retain
    source product identities, instance placements, dimensions, and validation
    results in bom.json. Mark unconfirmed purchasing specifications explicitly.
    Add 16 individual STEP exports, 16 part illustrations, and an upright
    assembly overview. Update English and Chinese hardware documentation with
    matching download links and 90px image thumbnails. Add FreeCAD extraction
    and Blender rendering scripts with reproduction instructions.
    Validation: local links in 14 Markdown files and structure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
2026-10-15 统一中文文档入口并按 R1 实测尺寸修订螺钉规格
    将各目录 README.md 设为中文正文，保留旧中文链接兼容页，更新中文维护规则和检查脚本。修正 SDK 克隆地址为重命名后的仓库。
    参考 102 的规格表达，核查三种 M3 × 4 推定螺钉与一种台阶件；保留源数量和未确认的采购属性，将圆柱尺寸核查纳入 BOM 提取流程。
    验证：15 份 Markdown 本地链接、7 个中文入口检查通过；从原始 STEP 重新提取 16 项、21 个顶层实例及 99 个实体，导出复核通过，四种螺钉规格与表格及 JSON 一致。
2026-10-15 将硬件资源直接整理到 hardware 目录
    移除 touch-leader-arm 中间目录，合并产品规格与图文 BOM 入口，更新文档导航、仓库结构及 CAD 提取和渲染脚本路径。
    验证：13 份 Markdown 本地链接与 6 个中文入口检查通过；40 个迁移文件逐字节一致，BOM 所有资源路径及原始 STEP 校验值有效。
